mathebaka/3bit-CR-DAC-DEMO/(list of files, drawings)

Other design files:
Multisim-simulation.ms14
