mathebaka/3bit-CR-DAC-DEMO/(commit log)

2025-10-18 PCB gerber files
2025-10-18 KiCad Schematic & PCB
2025-10-18 Multisim Simulation
    [CR DAC.ms14]
2025-10-19 Rename 3S BMS.webp to images/3S-BMS.webp
2025-10-19 Update and rename CR-DAC-Demo.svg to schematic.svg
2025-10-20 Rename CR DAC.ms14 to Multisim-simulation.ms14
    [Multisim-simulation.ms14]
2025-11-17 Rename KiCad files.zip.zip to KiCad files.zip
2026-05-05 Rename CR DAC schematic.svg to Schematic.svg
